armorsun/Drink-Servant/README.md

# Drink-Servant
A final project in Robotics course

# Equipments:
1. Six-wheel mobile robot
2. A robot arm modified from UArm
3. Echo dot
4. Kinect Xbox One
5. Nvidia TX2
6. Arduino Mega 2560

# Architecture:
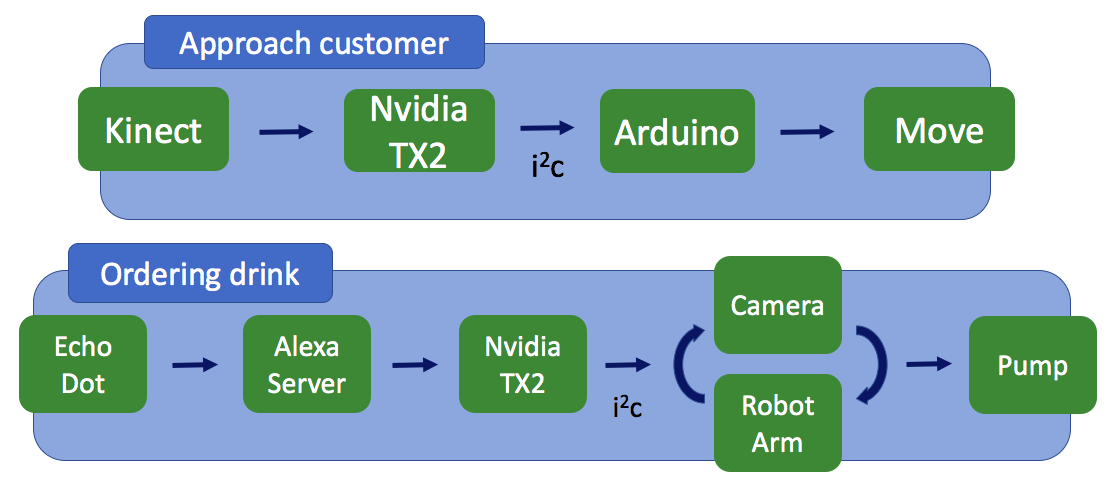
[picture p1: Architecture.png]
Architecture


# Video:
https://www.youtube.com/watch?v=tUzVZfe1XYk&t=22s
